Electrium-Mobility/F25-Media-Player-Elec/Import Parts/Models/PJ-327A.step

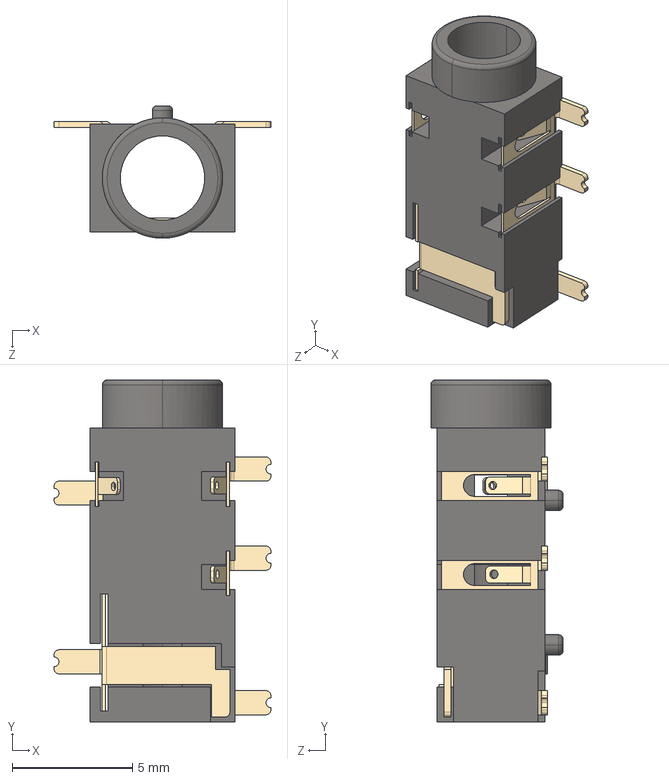
[picture p1: CAD file, 2025-11-14]
Import Parts/Models/PJ-327A.step
9.00 x 14.2 x 5.50 mm
