Electrium-Mobility/F25-Media-Player-Elec/Import Parts/Models/Same_Sky_SJ-3524-SMT-TR.step

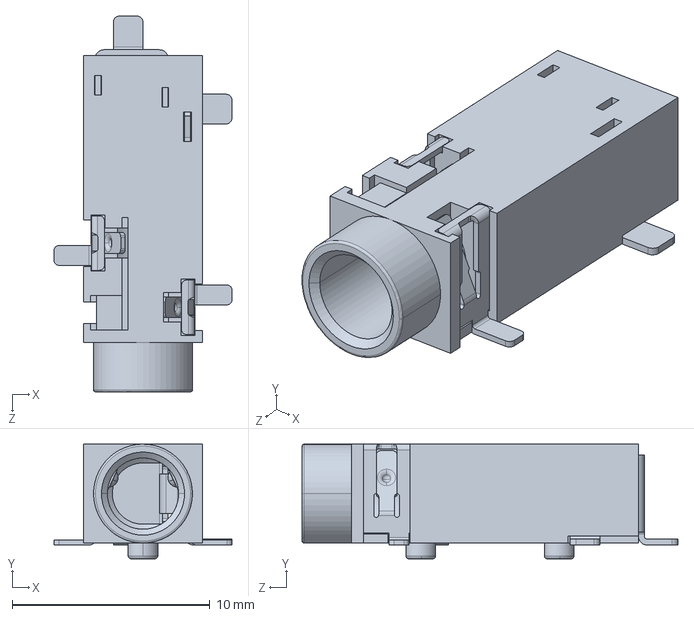
[picture p2: CAD file, 2025-11-05]
Import Parts/Models/Same_Sky_SJ-3524-SMT-TR.step
9.00 x 5.80 x 19.0 mm
