Electrium-Mobility/F25-Media-Player-Elec/Import Parts/Models/664_12402012E212A.stp

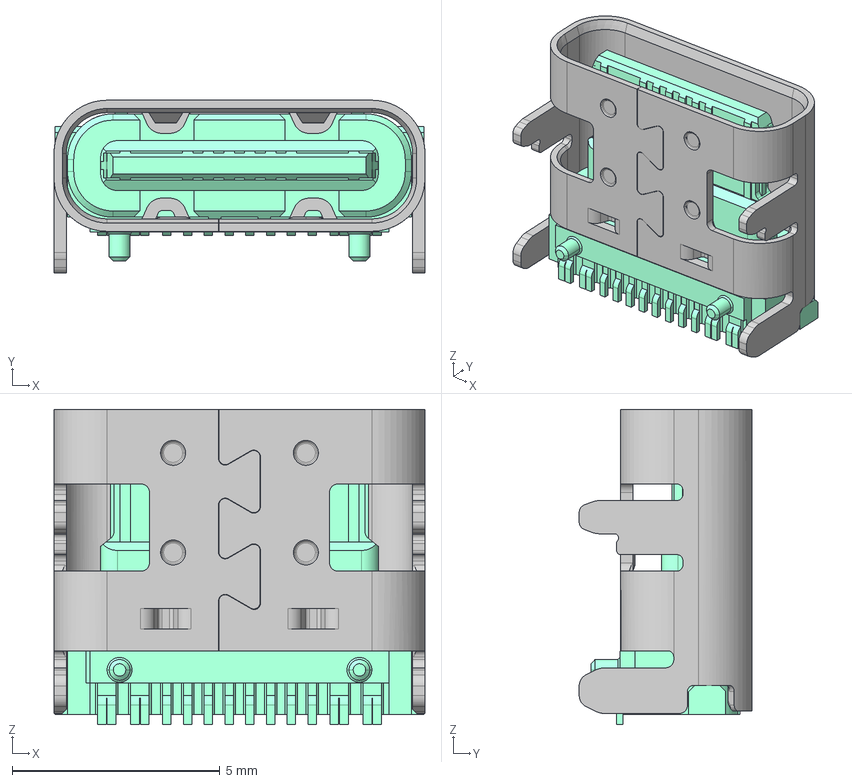
[picture p3: CAD file, 2025-11-05]
Import Parts/Models/664_12402012E212A.stp
8.94 x 4.16 x 7.60 mm
