Electrium-Mobility/F25-Media-Player-Elec/Import Parts/Models/MEM2075-00-140-01-A.stp

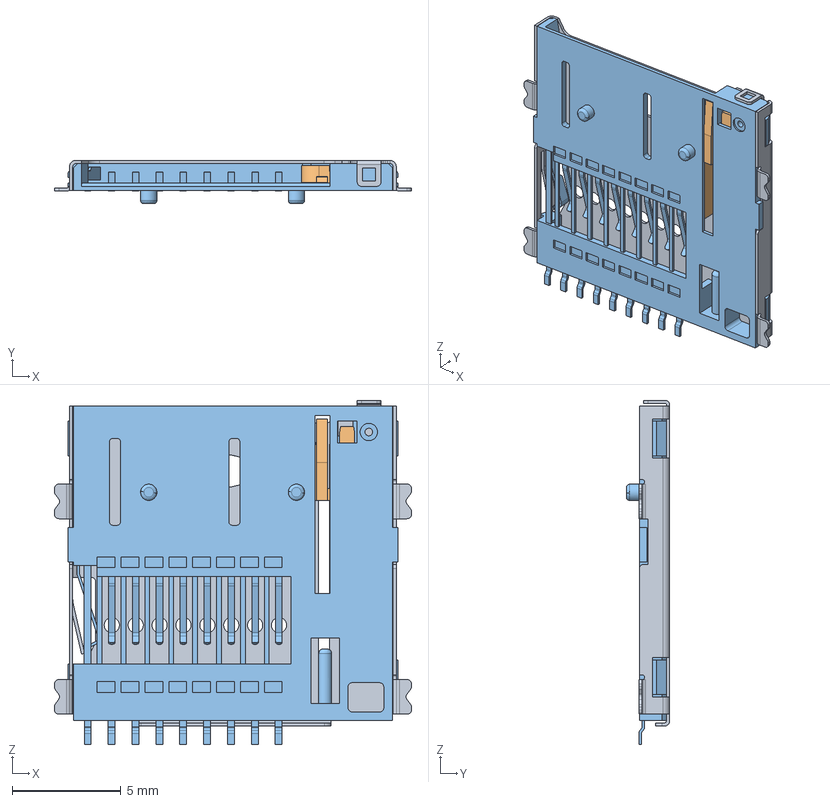
[picture p4: CAD file, 2025-11-05]
Import Parts/Models/MEM2075-00-140-01-A.stp
16.4 x 2.00 x 15.9 mm
MEM2075-00-140-01-A_PART1
MEM2075-00-140-01-A_PART2
MEM2075-00-140-01-A_PART3
