Electrium-Mobility/F25-Media-Player-Elec/Media Player.kicad_pcb

## KiCad design Media Player.kicad_pcb (2025-11-14)

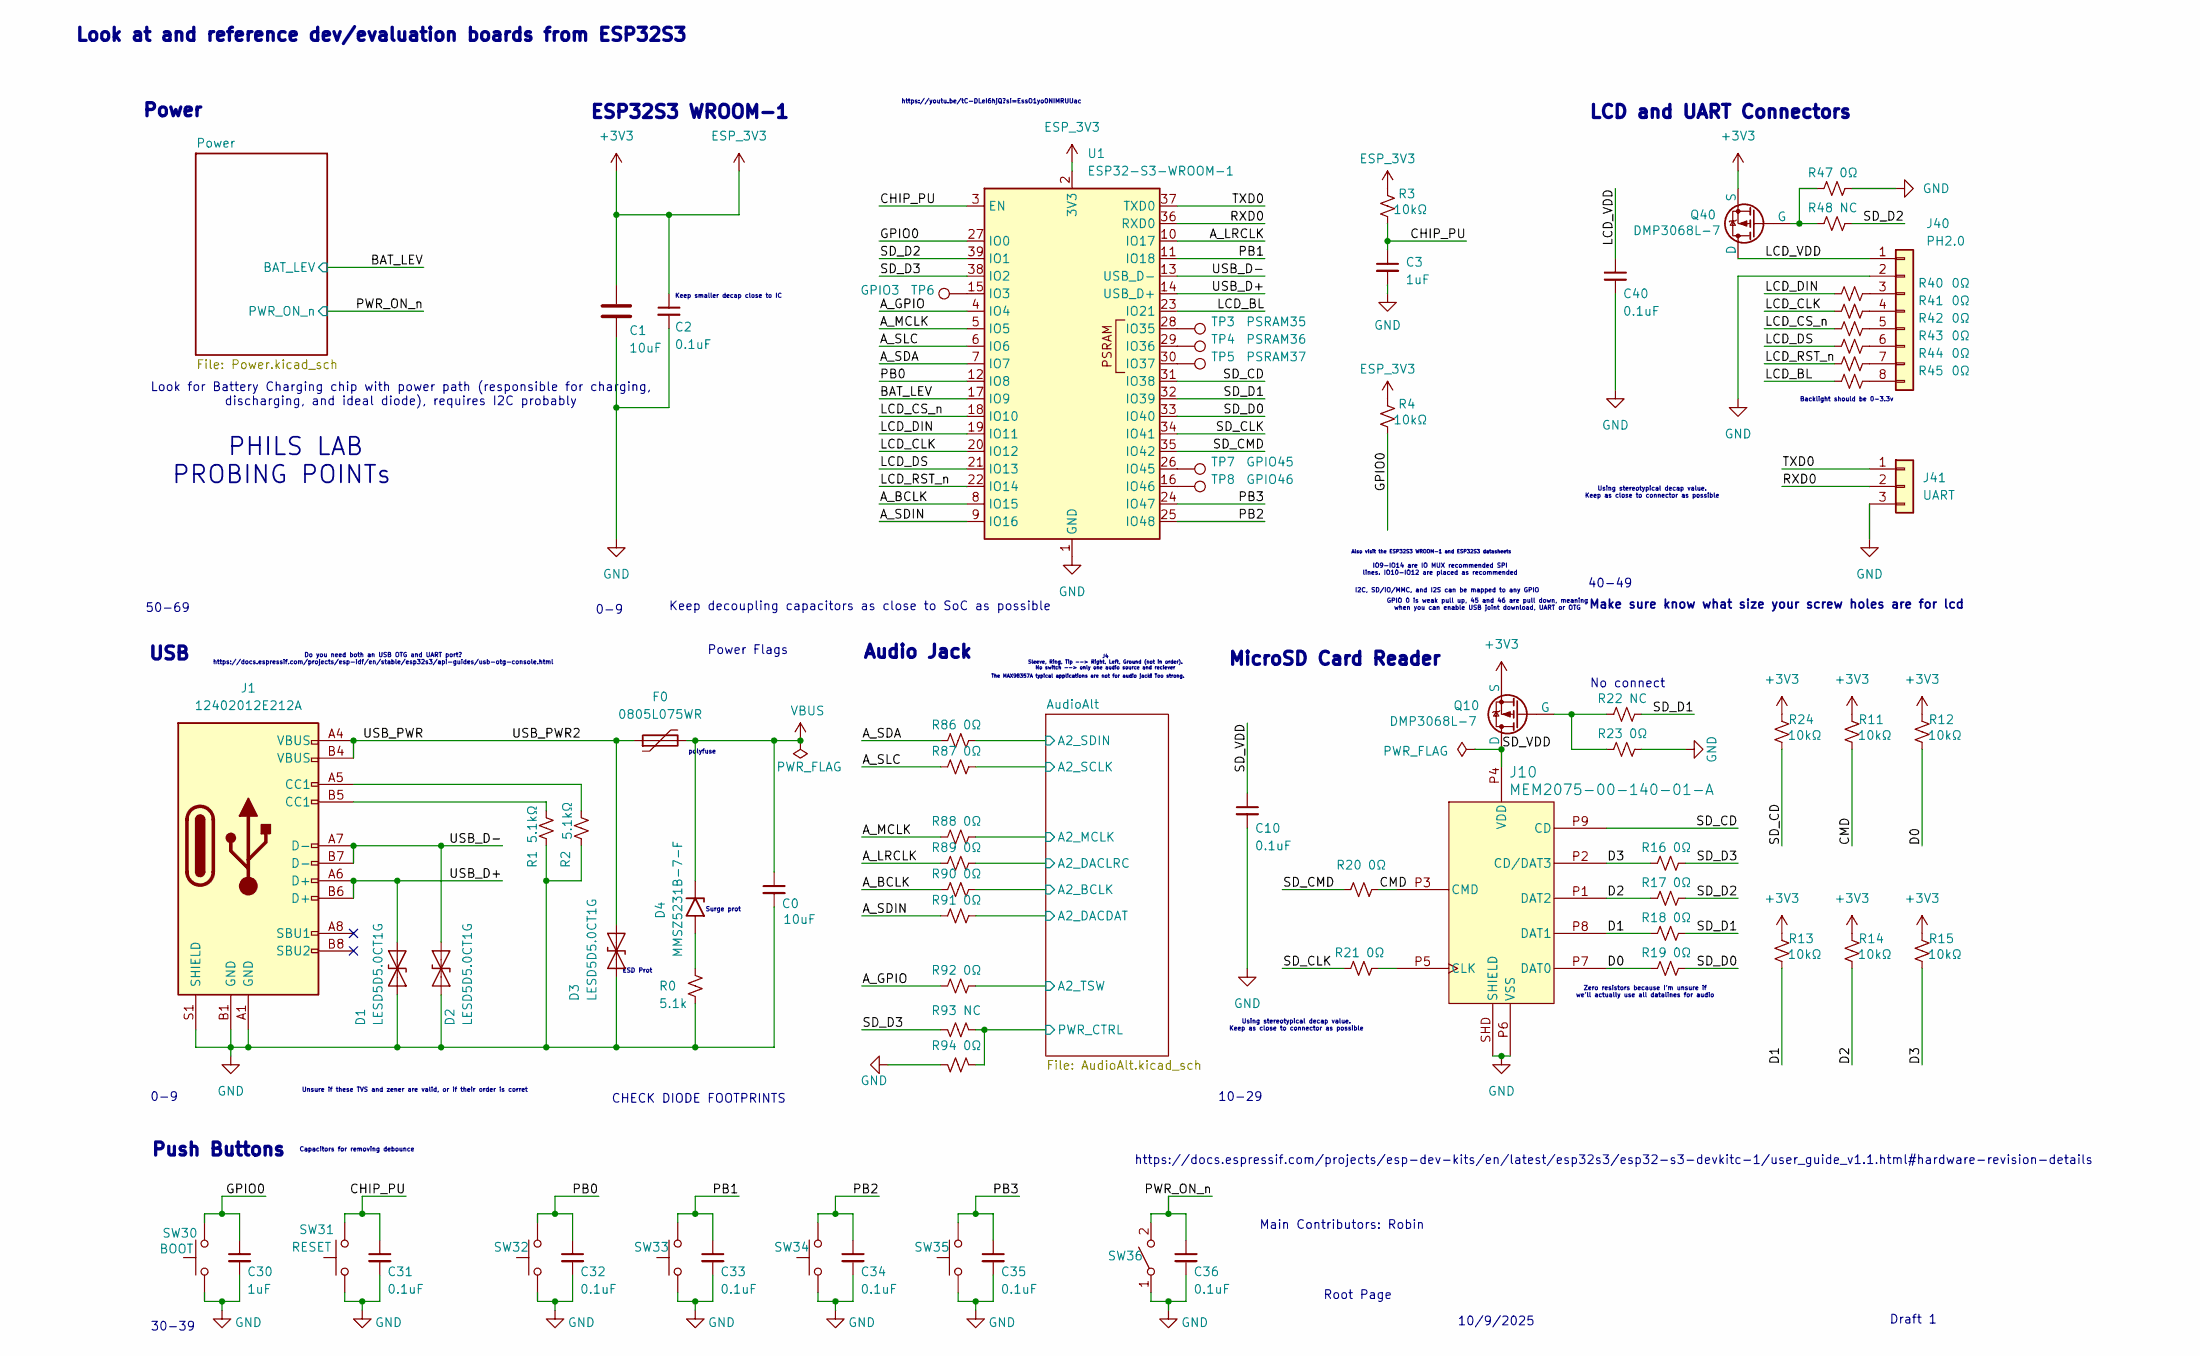
[picture p5: schematic Media Player.kicad_sch]

Parts:
C0: 10uF; C_0805_2012Metric_Pad1.18x1.45mm_HandSolder
C1: 10uF; C_0603_1608Metric_Pad1.08x0.95mm_HandSolder
C2, C10, C31, C32, C33, C34, C35, C36, C40: 0.1uF; C_0603_1608Metric_Pad1.08x0.95mm_HandSolder
C3, C30: 1uF; C_0603_1608Metric_Pad1.08x0.95mm_HandSolder
D1, D2, D3: LESD5D5.0CT1G; D_SOD-523
D4: MMSZ5231B-7-F; D_SOD-323
F0: 0805L075WR; D_0805_2012Metric_Pad1.15x1.40mm_HandSolder
J1: 12402012E212A; USB_C_12402012E212A_AMP
J10: MEM2075-00-140-01-A; MEM2075-00-140-01-A_GCT
J40: PH2.0; JST_EH_B8B-EH-A_1x08_P2.50mm_Vertical
J41: UART; JST_PH_B3B-PH-K_1x03_P2.00mm_Vertical
Q10, Q40: DMP3068L-7; SOT-23-3
R0: 5.1k; R_0603_1608Metric_Pad0.98x0.95mm_HandSolder
R1, R2: 5.1kΩ; R_0603_1608Metric_Pad0.98x0.95mm_HandSolder
R3, R4, R11, R12, R13, R14, R15, R24: 10kΩ; R_0603_1608Metric_Pad0.98x0.95mm_HandSolder
R16, R17, R18, R19, R20, R21, R23, R40, R41, R42, R43, R44, R45, R47, R86, R87, R88, R89, R90, R91, R92, R94: 0Ω; R_0603_1608Metric_Pad0.98x0.95mm_HandSolder
R22, R48, R93: NC; R_0603_1608Metric_Pad0.98x0.95mm_HandSolder
SW30: BOOT; SW_Push_1P1T_NO_CK_KSC6xxG
SW31: RESET; SW_Push_1P1T_NO_CK_KSC6xxG
SW32, SW33, SW34, SW35: SW_Push; SW_Push_1P1T_NO_CK_KSC6xxG
SW36: SW_SPST; SW_DIP_SPSTx01_Slide_6.7x4.1mm_W8.61mm_P2.54mm_LowProfile
TP3: PSRAM35; TestPoint_Pad_1.5x1.5mm
TP4: PSRAM36; TestPoint_Pad_1.5x1.5mm
TP5: PSRAM37; TestPoint_Pad_1.5x1.5mm
TP6: GPIO3; TestPoint_Pad_1.5x1.5mm
TP7: GPIO45; TestPoint_Pad_1.5x1.5mm
TP8: GPIO46; TestPoint_Pad_1.5x1.5mm
U1: ESP32-S3-WROOM-1

Connections:
+3V3: C1.1, C2.1, Q10.3 (S), Q40.3 (S), R3.2, R4.2, R11.2, R12.2, R13.2, R14.2, R15.2, R24.2, U1.2 (3V3); also elsewhere on the board
/A_BCLK: R90.1, U1.8 (IO15)
/A_GPIO: R92.1, U1.4 (IO4)
/A_LRCLK: R89.1, U1.10 (IO17)
/A_MCLK: R88.1, U1.5 (IO5)
/A_SDA: R86.1, U1.7 (IO7)
/A_SDIN: R91.1, U1.9 (IO16)
/A_SLC: R87.1, U1.6 (IO6)
/AudioAlt/A2_BCLK: R90.2; also elsewhere on the board
/AudioAlt/A2_DACDAT: R91.2; also elsewhere on the board
/AudioAlt/A2_DACLRC: R89.2; also elsewhere on the board
/AudioAlt/A2_MCLK: R88.2; also elsewhere on the board
/AudioAlt/A2_SCLK: R87.2; also elsewhere on the board
/AudioAlt/A2_SDIN: R86.2; also elsewhere on the board
/AudioAlt/A2_TSW: R92.2; also elsewhere on the board
/AudioAlt/PWR_CTRL: R93.1, R94.1; also elsewhere on the board
/BAT_LEV: U1.17 (IO9); also elsewhere on the board
/CHIP_PU: C3.1, C31.1, R3.1, SW31.2, U1.3 (EN)
/CMD: J10.P3 (CMD), R11.1, R20.2
/D0: J10.P7 (DAT0), R12.1, R19.1
/D1: J10.P8 (DAT1), R13.1, R18.1
/D2: J10.P1 (DAT2), R14.1, R17.1
/D3: J10.P2 (CD/DAT3), R15.1, R16.1
/GPIO0: C30.1, R4.1, SW30.2, U1.27 (IO0)
/LCD_BL: R45.1, U1.23 (IO21)
/LCD_CLK: R41.1, U1.20 (IO12)
/LCD_CS_n: R42.1, U1.18 (IO10)
/LCD_DIN: R40.1, U1.19 (IO11)
/LCD_DS: R43.1, U1.21 (IO13)
/LCD_RST_n: R44.1, U1.22 (IO14)
/LCD_VDD: C40.1, J40.1, Q40.1 (D)
/PB0: C32.1, SW32.2, U1.12 (IO8)
/PB1: C33.1, SW33.2, U1.11 (IO18)
/PB2: C34.1, SW34.2, U1.25 (IO48)
/PB3: C35.1, SW35.2, U1.24 (IO47)
/PWR_ON_n: C36.1, SW36.2 (B); also elsewhere on the board
/RXD0: J41.2, U1.36 (RXD0)
/SD_CD: J10.P9 (CD), R24.1, U1.31 (IO38)
/SD_CLK: R21.1, U1.34 (IO41)
/SD_CMD: R20.1, U1.35 (IO42)
/SD_D0: R19.2, U1.33 (IO40)
/SD_D1: R18.2, R22.2, U1.32 (IO39)
/SD_D2: R17.2, R48.2, U1.39 (IO1)
/SD_D3: R16.2, R93.2, U1.38 (IO2)
/SD_VDD: C10.1, J10.P4 (VDD), Q10.1 (D)
/TXD0: J41.1, U1.37 (TXD0)
/USB_D+: D1.1 (A1), J1.A6 (D+), J1.B6 (D+), U1.14 (USB_D+)
/USB_D-: D2.1 (A1), J1.A7 (D-), J1.B7 (D-), U1.13 (USB_D-)
/USB_PWR: D3.1 (A1), F0.1, J1.A4 (VBUS), J1.A9 (VBUS), J1.B4 (VBUS), J1.B9 (VBUS)
GND: C0.2, C1.2, C2.2, C3.2, C10.2, C30.2, C31.2, C32.2, C33.2, C34.2, C35.2, C36.2, C40.2, D1.2 (A2), D2.2 (A2), D3.2 (A2), J1.A1 (GND), J1.A12 (GND), J1.B1 (GND), J1.B12 (GND), J1.S1 (SHIELD), J10.P6 (VSS), J10.SHD (SHIELD), J40.2, J41.3, R0.2, R1.2, R2.2, R23.2, R47.2, R94.2, SW30.1, SW31.1, SW32.1, SW33.1, SW34.1, SW35.1, SW36.1 (A), U1.1 (GND), U1.40 (GND), U1.41 (GND); also elsewhere on the board
unnamed: D4.2 (A2), R0.1
unnamed: J1.A5 (CC1), R2.1
unnamed: J1.B5 (CC1), R1.1
unnamed: J10.P5 (CLK), R21.2
unnamed: J40.3, R40.2
unnamed: J40.4, R41.2
unnamed: J40.5, R42.2
unnamed: J40.6, R43.2
unnamed: J40.7, R44.2
unnamed: J40.8, R45.2
unnamed: Q10.2 (G), R22.1, R23.1
unnamed: Q40.2 (G), R47.1, R48.1
unnamed: TP6.1, U1.15 (IO3)
unnamed: TP3.1, U1.28 (IO35)
unnamed: TP4.1, U1.29 (IO36)
unnamed: TP5.1, U1.30 (IO37)
unnamed: TP7.1, U1.26 (IO45)
unnamed: TP8.1, U1.16 (IO46)
VBUS: C0.1, D4.1 (A1), F0.2; also elsewhere on the board

Notes on the sheet:
LCD and UART Connectors
Look for Battery Charging chip with power path (responsible for charging, discharging, and ideal diode), requires I2C probably
Keep decoupling capacitors as close to SoC as possible
50-69
ESP32S3 WROOM-1
Capacitors for removing debounce
Look at and reference dev/evaluation boards from ESP32S3
IO9-IO14 are IO MUX recommended SPI lines. IO10-IO12 are placed as recommended
Make sure know what size your screw holes are for lcd
GPIO 0 is weak pull up, 45 and 46 are pull down, meaning when you can enable USB joint download, UART or OTG
Push Buttons
Using stereotypical decap value. Keep as close to connector as possible
MicroSD Card Reader
Backlight should be 0-3.3v
0-9
I2C, SD/IO/MMC, and I2S can be mapped to any GPIO
Surge prot
10/9/2025
Root Page
Zero resistors because I'm unsure if we'll actually use all datalines for audio
10-29
Unsure if these TVS and zener are valid, or if their order is corret
CHECK DIODE FOOTPRINTS
Power
polyfuse
40-49
Audio Jack
30-39
Do you need both an USB OTG and UART port? https://docs.espressif.com/projects/esp-idf/en/stable/esp32s3/api-guides/usb-otg-console.html
PROBING POINTs
The MAX98357A typical applications are not for audio jack! Too strong.
Also visit the ESP32S3 WROOM-1 and ESP32S3 datasheets
Keep smaller decap close to IC
Main Contributors: Robin
No connect
PHILS LAB
Draft 1
ESD Prot
USB
https://docs.espressif.com/projects/esp-dev-kits/en/latest/esp32s3/esp32-s3-devkitc-1/user_guide_v1.1.html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
J4 Sleeve, Ring, Tip --> Right, Left, Ground (not in order). No switch --> only one audio source and reciever
Power Flags
https://youtu.be/tC-DLeI6hjQ?si=EssO1yo0NIMRUUac

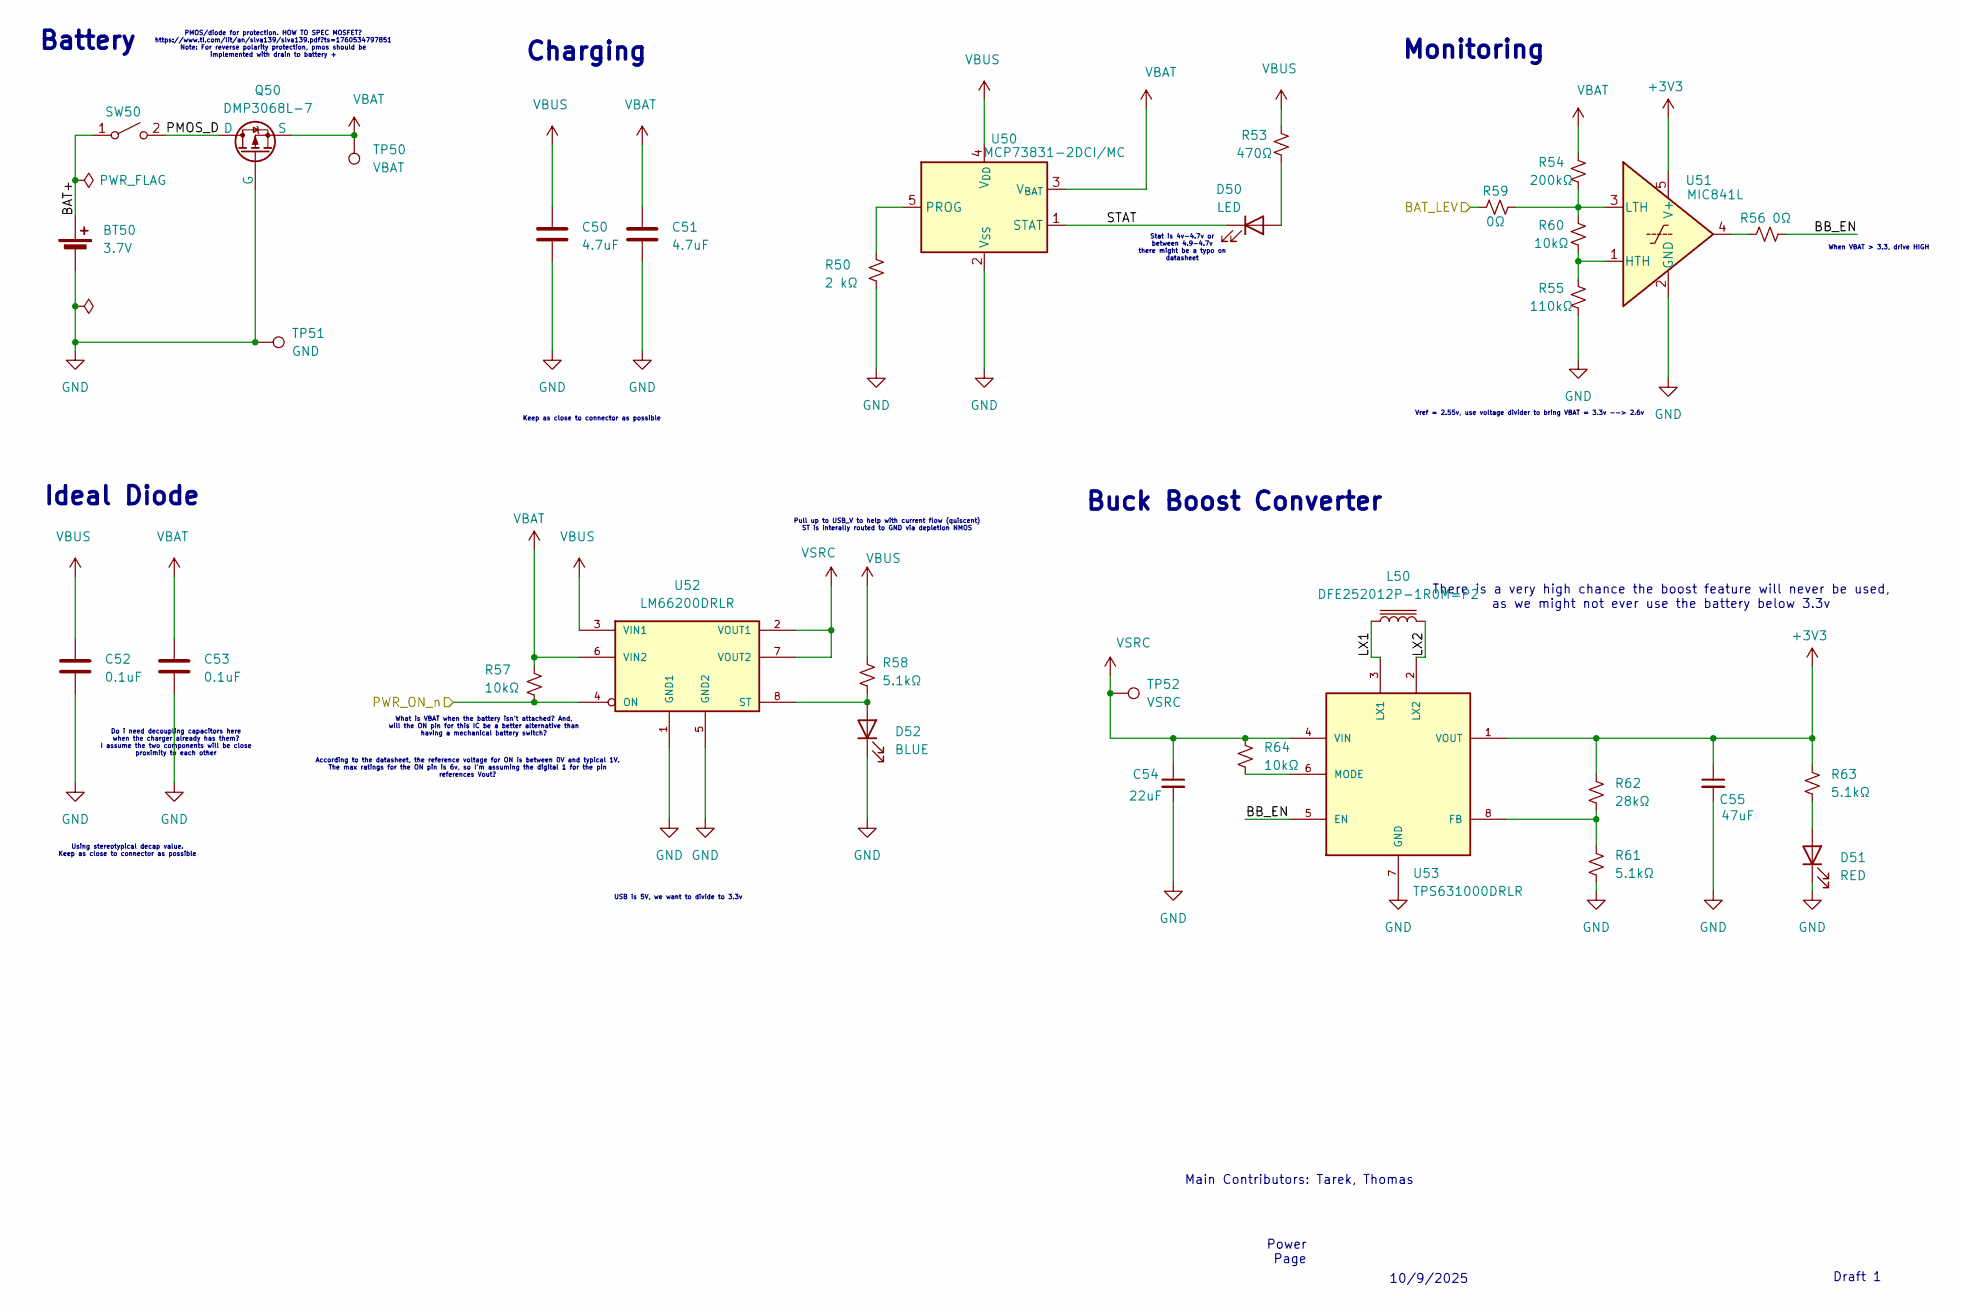
[picture p6: schematic Power.kicad_sch]

Parts:
BT50: 3.7V; JST_PH_B2B-PH-K_1x02_P2.00mm_Vertical
C50, C51: 4.7uF; C_0603_1608Metric_Pad1.08x0.95mm_HandSolder
C52, C53: 0.1uF; C_0603_1608Metric_Pad1.08x0.95mm_HandSolder
C54: 22uF; C_0805_2012Metric
C55: 47uF; C_0805_2012Metric
D50: LED; LED_0603_1608Metric
D51: RED; LED_0603_1608Metric
D52: BLUE; LED_0603_1608Metric
L50: DFE252012P-1R0M=P2; L_1008_2520Metric
Q50: DMP3068L-7; SOT-23-3
R50: 2 kΩ; R_0603_1608Metric_Pad0.98x0.95mm_HandSolder
R53: 470Ω; R_0603_1608Metric_Pad0.98x0.95mm_HandSolder
R54: 200kΩ; R_0603_1608Metric_Pad0.98x0.95mm_HandSolder
R55: 110kΩ; R_0603_1608Metric_Pad0.98x0.95mm_HandSolder
R56, R59: 0Ω; R_0603_1608Metric_Pad0.98x0.95mm_HandSolder
R57, R60, R64: 10kΩ; R_0603_1608Metric_Pad0.98x0.95mm_HandSolder
R58, R61, R63: 5.1kΩ; R_0603_1608Metric_Pad0.98x0.95mm_HandSolder
R62: 28kΩ; R_0603_1608Metric_Pad0.98x0.95mm_HandSolder
SW50: SW_SPST; SW_DIP_SPSTx01_Slide_6.7x4.1mm_W8.61mm_P2.54mm_LowProfile
TP50: VBAT; TestPoint_Pad_1.5x1.5mm
TP51: GND; TestPoint_THTPad_1.5x1.5mm_Drill0.7mm
TP52: VSRC; TestPoint_Pad_1.5x1.5mm
U50: MCP73831-2DCI/MC; SOT-23-5
U51: MIC841L; SOT-353_SC-70-5
U52: LM66200DRLR; SOT-583-8
U53: TPS631000DRLR; SOT-583-8; PARTREV B

Connections:
+3V3: C55.1, R62.1, R63.1, U51.5 (V+), U53.1 (VOUT); also elsewhere on the board
/BAT_LEV: R59.2; also elsewhere on the board
/PWR_ON_n: R57.2, U52.4 (ON); also elsewhere on the board
/Power/BAT+: BT50.1 (+), SW50.1 (A)
/Power/BB_EN: R56.2, U53.5 (EN)
/Power/LX1: L50.1, U53.3 (LX1)
/Power/LX2: L50.2, U53.2 (LX2)
/Power/PMOS_D: Q50.1 (D), SW50.2 (B)
/Power/STAT: D50.1 (K), U50.1 (STAT)
GND: BT50.2 (-), C50.1, C51.1, C52.1, C53.1, C54.2, C55.2, D51.1 (K), D52.1 (K), Q50.2 (G), R50.2, R55.1, R61.2, TP51.1, U50.2 (V_{SS}), U51.2 (GND), U52.1 (GND1), U52.5 (GND2), U53.7 (GND); also elsewhere on the board
unnamed: D50.2 (A), R53.1
unnamed: D51.2 (A), R63.2
unnamed: D52.2 (A), R58.2, U52.8 (ST)
unnamed: R56.1, U51.4
unnamed: R50.1, U50.5 (PROG)
unnamed: R55.2, R60.1, U51.1 (HTH)
unnamed: R54.1, R59.1, R60.2, U51.3 (LTH)
unnamed: R61.1, R62.2, U53.8 (FB)
unnamed: R64.2, U53.6 (MODE)
VBAT: C51.2, C53.2, Q50.3 (S), R54.2, R57.1, TP50.1, U50.3 (V_{BAT}), U52.6 (VIN2)
VBUS: C50.2, C52.2, R53.2, R58.1, U50.4 (V_{DD}), U52.3 (VIN1); also elsewhere on the board
VSRC: C54.1, R64.1, TP52.1, U52.2 (VOUT1), U52.7 (VOUT2), U53.4 (VIN)

Notes on the sheet:
Pull up to USB_V to help with current flow (quiscent) ST is interally routed to GND via depletion NMOS
Power Page
Vref = 2.55v, use voltage divider to bring VBAT = 3.3v --> 2.6v
Do i need decoupling capacitors here when the charger already has them? I assume the two components will be close proximity to each other
According to the datasheet, the reference voltage for ON is between 0V and typical 1V. The max ratings for the ON pin is 6v, so I'm assuming the digital 1 for the pin references Vout?
What is VBAT when the battery isn't attached? And, will the ON pin for this IC be a better alternative than having a mechanical battery switch?
Keep as close to connector as possible
Charging
Main Contributors: Tarek, Thomas
Battery
10/9/2025
There is a very high chance the boost feature will never be used, as we might not ever use the battery below 3.3v
When VBAT > 3.3, drive HIGH
Ideal Diode
Using stereotypical decap value. Keep as close to connector as possible
Buck Boost Converter
Draft 1
USB is 5V, we want to divide to 3.3v
Monitoring
PMOS/diode for protection. HOW TO SPEC MOSFET? https://www.ti.com/lit/an/slva139/slva139.pdf?ts=1760534797851 Note: For reverse polarity protection, pmos should be implemented with drain to battery +
Stat is 4v-4.7v or between 4.9-4.7v there might be a typo on datasheet

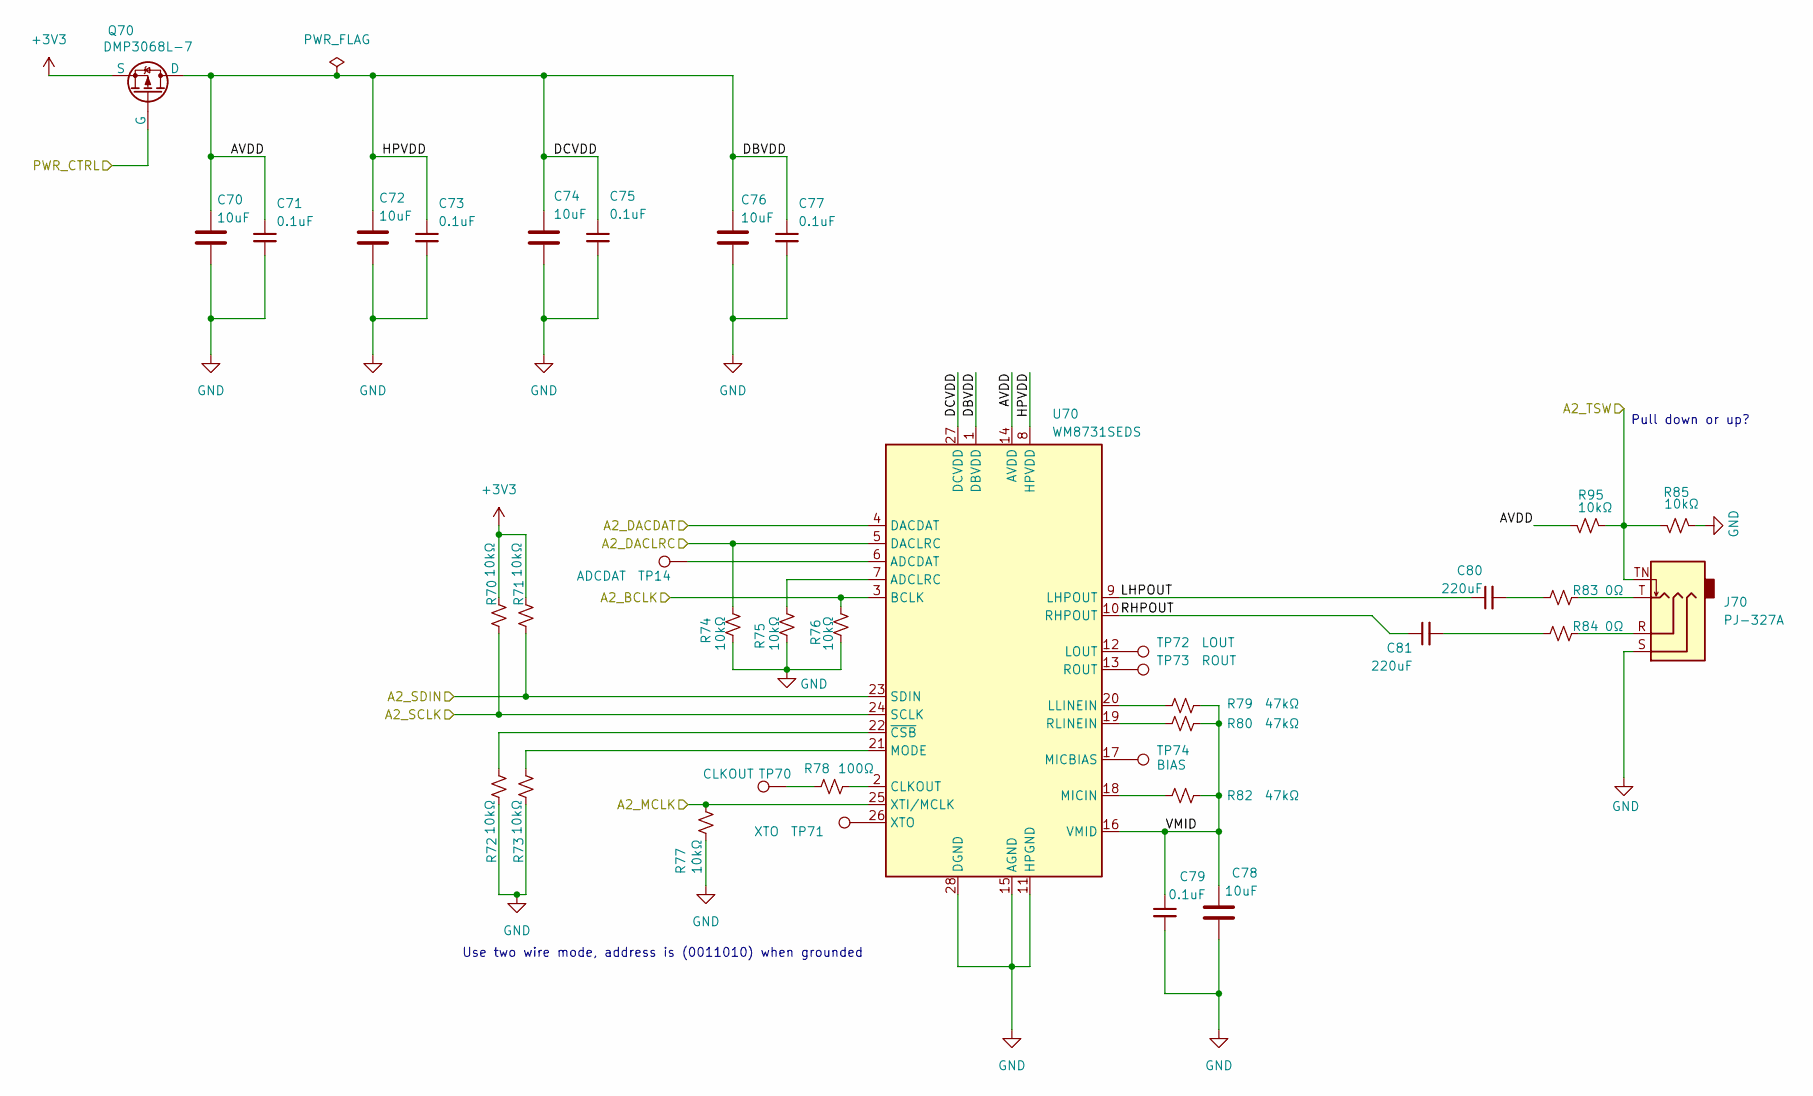
[picture p7: schematic AudioAlt.kicad_sch]

Parts:
C70, C72, C74, C76, C78: 10uF; C_0603_1608Metric_Pad1.08x0.95mm_HandSolder
C71, C73, C75, C77, C79: 0.1uF; C_0603_1608Metric_Pad1.08x0.95mm_HandSolder
C80, C81: 220uF; C_0603_1608Metric_Pad1.08x0.95mm_HandSolder
J70: PJ-327A; Korean Hroparts Elec PJ-327C-4A
Q70: DMP3068L-7; SOT-23-3
R70, R71, R72, R73, R74, R75, R76, R77, R85, R95: 10kΩ; R_0603_1608Metric_Pad0.98x0.95mm_HandSolder
R78: 100Ω; R_0603_1608Metric_Pad0.98x0.95mm_HandSolder
R79, R80, R82: 47kΩ; R_0603_1608Metric_Pad0.98x0.95mm_HandSolder
R83, R84: 0Ω; R_0603_1608Metric_Pad0.98x0.95mm_HandSolder
TP14: ADCDAT; TestPoint_Pad_1.5x1.5mm
TP70: CLKOUT; TestPoint_Pad_1.5x1.5mm
TP71: XTO; TestPoint_Pad_1.5x1.5mm
TP72: LOUT; TestPoint_Pad_1.5x1.5mm
TP73: ROUT; TestPoint_Pad_1.5x1.5mm
TP74: BIAS; TestPoint_Pad_1.5x1.5mm
U70: WM8731SEDS; SSOP-28_5.3x10.2mm_P0.65mm

Connections:
+3V3: Q70.3 (S), R70.1, R71.1; also elsewhere on the board
/AudioAlt/A2_BCLK: R76.1, U70.3 (BCLK); also elsewhere on the board
/AudioAlt/A2_DACDAT: U70.4 (DACDAT); also elsewhere on the board
/AudioAlt/A2_DACLRC: R74.1, U70.5 (DACLRC); also elsewhere on the board
/AudioAlt/A2_MCLK: R77.1, U70.25 (XTI/MCLK); also elsewhere on the board
/AudioAlt/A2_SCLK: R70.2, U70.24 (SCLK); also elsewhere on the board
/AudioAlt/A2_SDIN: R71.2, U70.23 (SDIN); also elsewhere on the board
/AudioAlt/A2_TSW: J70.TN, R85.1, R95.2; also elsewhere on the board
/AudioAlt/AVDD: C70.1, C71.1, C72.1, C73.1, C74.1, C75.1, C76.1, C77.1, Q70.1 (D), R95.1, U70.1 (DBVDD), U70.8 (HPVDD), U70.14 (AVDD), U70.27 (DCVDD)
/AudioAlt/LHPOUT: C80.1, U70.9 (LHPOUT)
/AudioAlt/PWR_CTRL: Q70.2 (G); also elsewhere on the board
/AudioAlt/RHPOUT: C81.1, U70.10 (RHPOUT)
/AudioAlt/VMID: C78.1, C79.1, R79.1, R80.1, R82.1, U70.16 (VMID)
GND: C70.2, C71.2, C72.2, C73.2, C74.2, C75.2, C76.2, C77.2, C78.2, C79.2, J70.S, R72.2, R73.2, R74.2, R75.2, R76.2, R77.2, R85.2, U70.11 (HPGND), U70.15 (AGND), U70.28 (DGND); also elsewhere on the board
unnamed: C80.2, R83.1
unnamed: C81.2, R84.1
unnamed: J70.R, R84.2
unnamed: J70.T, R83.2
unnamed: R78.2, TP70.1
unnamed: TP14.1, U70.6 (ADCDAT)
unnamed: R75.1, U70.7 (ADCLRC)
unnamed: R78.1, U70.2 (CLKOUT)
unnamed: R79.2, U70.20 (LLINEIN)
unnamed: TP72.1, U70.12 (LOUT)
unnamed: TP74.1, U70.17 (MICBIAS)
unnamed: R82.2, U70.18 (MICIN)
unnamed: R73.1, U70.21 (MODE)
unnamed: R80.2, U70.19 (RLINEIN)
unnamed: TP73.1, U70.13 (ROUT)
unnamed: TP71.1, U70.26 (XTO)
unnamed: R72.1, U70.22 (~CSB)

Notes on the sheet:
Use two wire mode, address is (0011010) when grounded
Pull down or up?

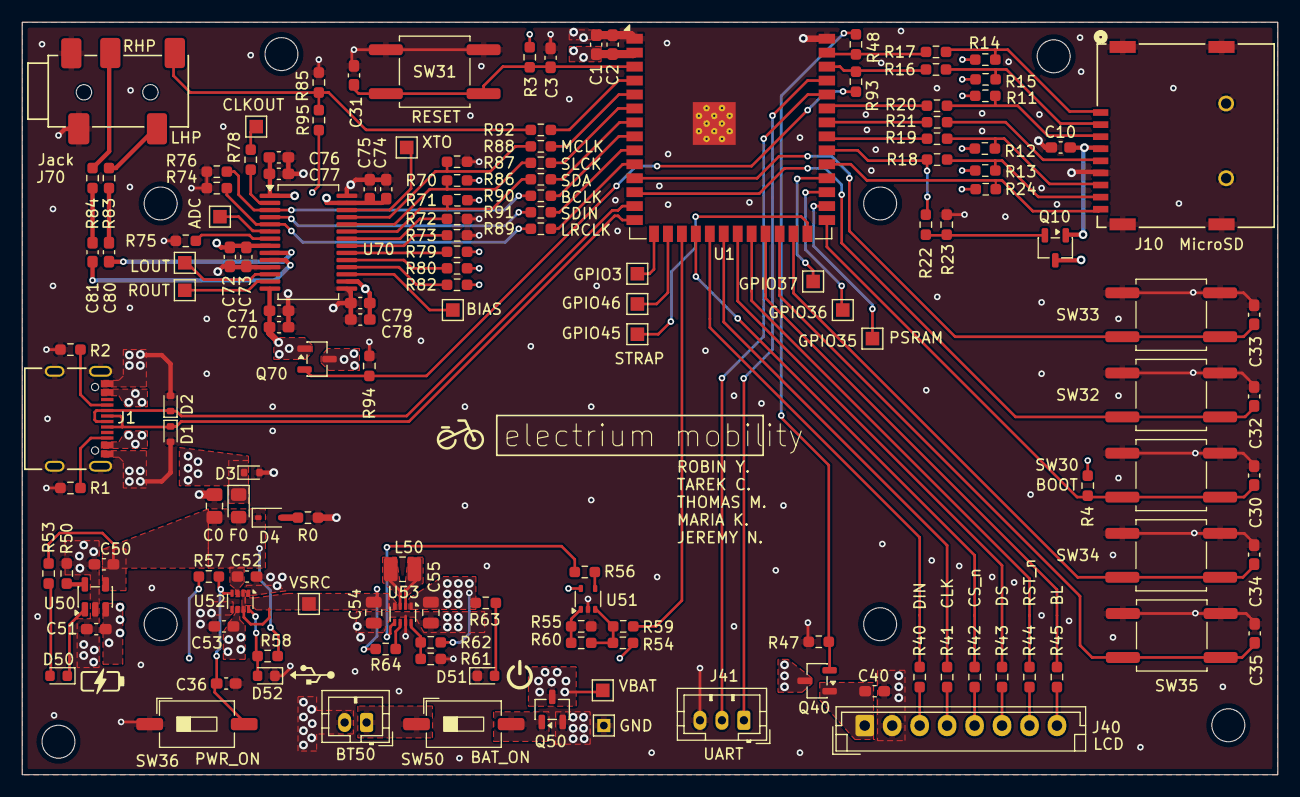
[picture p8: board Media Player.kicad_pcb from above]

Board: 4 copper layers, 114.3 x 68.5 mm, 144 parts (0 on the bottom side), 107 nets.
