Electrium-Mobility/F25-Media-Player-Elec/(commit log)

2025-10-02 Update Media Player.kicad_sch
    [Media Player.kicad_sch]
2025-10-03 Added Power sub page.
    [Media Player.kicad_sch, Power.kicad_sch]
2025-10-03 Placed Major Components, No Power
    Placed ESP32S3, Connector to LCD, SD card reader, USB. Audio Jack components still tbd. Power is a hierarchical page/symbol, no pins right now.
    Note to self: KiCAD will crash if you try to edit symbols by double clicking on them inside a schematic. Use symbol editor instead.
    [Media Player.kicad_sch]
2025-10-07 Most connections formed except component values and audio amp
    [Media Player.kicad_sch, Power.kicad_sch]
2025-10-08 Changed Audio Amplifier to MAX9850
    MAX9850 is so complicated - you use I2C to set the internal registers to modify and initialize the IC before you use I2S to send audio data to DAC. You can also choose to send analog data with AC coupling capacitors. Output can go to speaker and headphone jack. Very versatile, extremely annoying reading a 36 page data sheet for 2 hours. No power yet.
    [Audio.kicad_sch, Media Player.kicad_sch]
2025-10-09 Draft 1 - Main components and wiring complete
    Connections may be innacurate or violate electrical specs, or perhaps aren't set up "properly".
    [Audio.kicad_sch, Media Player.kicad_sch, Power.kicad_sch]
2025-10-09 Added missing datasheets.
    [Audio.kicad_sch, Media Player.kicad_sch, Power.kicad_sch]
2025-10-09 Added PMOS to battery + power flags
    Still missing values for a lot of components
    [Audio.kicad_sch, Media Player.kicad_sch, Power.kicad_sch]
2025-10-12 Added most of the footprints needed
    [Audio.kicad_sch, Media Player.kicad_sch, Power.kicad_sch]
2025-10-13 Finished off the last footprints
    [Audio.kicad_sch, Media Player.kicad_sch, Power.kicad_sch]
2025-10-15 Draft 2: Protection circuitry and fixed I/O signals
    Still missing PMOS spec for reverse polarity battery protection. Added TVS to USB, voltage divided certain output signals from ICs into ESP GPIO. Checked some component values.
    [Audio.kicad_sch, Media Player.kicad_sch, Power.kicad_sch]
2025-10-15 Removed comment block
    [Media Player.kicad_sch]
2025-10-17 Draft 2 Revision 2
    Footprints still not all assigned.
    Added: Test points, zero resistors, battery voltage monitor IC, PTC and zener surge protection on VBUS, UART connector
    Changed: rerouted some signals, removed zener and resistor for reverse pol bat protection
    [Audio.kicad_sch, Media Player.kicad_sch, Power.kicad_sch]
2025-10-20 Remaining Footprint Added
    Beware of footprints that come from online but do not match the kicad libraries - the pins might be mapped wrong!
    [Audio.kicad_sch, Media Player.kicad_sch, Power.kicad_sch]
2025-10-20 Components Placed on Layout
    Added Power Management PMOS, Assigned missing footprints
    [Audio.kicad_sch, Media Player.kicad_pcb, Media Player.kicad_sch, Power.kicad_sch]
2025-10-20 Filtered Ratsnest
    Moved all related components into their respective groups
    [Media Player.kicad_pcb]
2025-10-24 Ratsnest organized
    Certain pins on esp32 module changed to benefit layout. Named all decaps to dC. Current layout areas might be not optimal, i.e. complicated to wire
    [Audio.kicad_sch, Media Player.kicad_pcb, Media Player.kicad_sch, Power.kicad_sch]
2025-10-27 Component Re-order
    [Media Player.kicad_pcb, Media Player.kicad_sch]
2025-10-27 Added alternative audio IC
    Added a SOP package audio IC (for easier board bring up) in hopes to replace MAX9850. Pins not fully mapped yet.
    [Audio.kicad_sch, AudioAlt.kicad_sch, Media Player.kicad_sch, untitled.kicad_sch]
2025-10-29 Board stuffing, new audio on board
    Added new Audio IC to PCB.
    Started moving everything into a estimated board size, AKA restricted area. Things seem REALL TIGHT. There's not enough space, I think I'll have to change resistor footprints
    [AudioAlt.kicad_sch, Media Player.kicad_pcb, Media Player.kicad_sch]
2025-10-31 Draft 1
    I'm not very fond of some of my traces. Especially the power component. Not even sure if all components are routed properly. Still missing GND and PWR plane, so most component power not routed. Missing LCD screw holes. Power and signal traces are using same width/thickness, and also have not checked with what JLC allows during fabrication. I should try again, working from general (blocking) to specifics (details), much like how I started with schematics. Many conventions I have not learned.
    [Media Player.kicad_pcb, Media Player.kicad_sch]
2025-10-31 Temporary Commit
    [Media Player.kicad_pcb]
2025-11-01 Small Change to USB routing
    Removed 0 resistors and change components to match reference schematic
    [Media Player.kicad_pcb, Media Player.kicad_sch, Power.kicad_sch]
2025-11-01 Compacting part 1
    [AudioAlt.kicad_sch, Media Player.kicad_pcb, Media Player.kicad_sch, Power.kicad_sch]
2025-11-03 Compacting Part 2, Pre-Draft 2
    Compacted more parts. Organized power routing and added envisioned power plane sections. Added screw holes for board and LCD. Shrunk max board size down.
    Still need to replace the diode for surge prot as the copper pads are way too small for direction large amounts of current.
    [Media Player.kicad_pcb]
2025-11-05 JLC Design restraints
    Updated design rules with JLC PCB. Combined numbers from Phils Lab and GPT for beginner friendly values (first board)
    [664_12402012E212A.stp, MEM2075-00-140-01-A.stp, Media Player.kicad_pcb, Media Player.kicad_sch, Same_Sky_SJ-3524-SMT-TR.step]
2025-11-05 Bucked
    The Boost Buck Converter layout is from the datasheet. I'm not really sure how many via's I'll need for power since the IC is so small yet its the only source of power feeding all the other peripherals.
    [Media Player.kicad_pcb, Power.kicad_sch]
2025-11-06 Ideal Diode
    Layout based on ds
    [Media Player.kicad_pcb]
2025-11-07 Layout Draft 2, or almost
    Charger layout based off of reference. Used more copper regions rather than traces. Other traces like buttons and test pads routed. Tried my best to make it all look good and parallel.
    Added more silkscreen and logo.
    STILL NEED TO DO POWER PLANE.
    [Media Player.kicad_pcb, Media Player.kicad_sch, Power.kicad_sch]
2025-11-07 Layout 2! Pre-DRC
    32 DRC errors. 116 Warnings.
    Inserted power planes. Now is time for optimization and fixing.
    [Media Player.kicad_pcb]
2025-11-08 Most DRC errors removed EXCEPT USB
    USB receptacle pins are too close to each other and the design rules I set are upset
    (31 errors, 1.9mm instead of the minimum 2.0mm)
    [Media Player.kicad_pcb]
2025-11-09 Copper Ground Pour, Traces Moved to Upper Layer
    Replaced gnd trace around D+ D- and SDIO CLK with full board GND pour. DRC issues with gnd pour right now. Also moved a lot of un-necessary back layer signal traces to top layer. DRC still somewhat unfixed.
    [Media Player.kicad_pcb]
2025-11-11 Minor Changes
    Power traces enlarged, certain pad and hole clearances on USB modified, still within design rules, fixed silk screen clearance, copper pours now with thermal relief for pads connected to large planes. Most DRC's resolved. Design rule constraints tuned very slightly.
    [Media Player.kicad_pcb]
2025-11-13 Ground Stitching, PMOS 0-Res Moved,
    DRC should be near cleared. Might want to reconsider mapping some pin functions? SD card detect line, also battery checker (making use of comparator). Also, double check if audio IC microphone pins (and ADC) are supposed to be pulled to VMID
    [AudioAlt.kicad_sch, Media Player.kicad_pcb, Media Player.kicad_sch, Power.kicad_sch]
2025-11-14 UNFINISHED: Rerouted Traces, new LEDs, replaced components
    Removed charging status and power source signals from MCU and gave them their own LEDs. Added analog battery voltage and card detect as replacement. Also found out not all components are in stock... troubling to find replacements :( should have done this during schematic
    [AudioAlt.kicad_sch, Media Player.kicad_pcb, Media Player.kicad_sch, Power.kicad_sch]
2025-11-14 New Audio Jack
    Replaced audio jack with actually available component from xunpu, changed MIC845 to MIC841. Still need to double check the audio codec
    [Media Player.kicad_pcb, PJ-327A.step]
2025-11-14 No changes made.
    [AudioAlt.kicad_sch, Media Player.kicad_pcb]
2025-11-14 ORDERED: Updated Footprints, Silk Screen, Mounting Holes
    Minor changes. This is the version sent to JLC
    [AudioAlt.kicad_sch, Media Player.kicad_pcb, Media Player.kicad_sch, MediaPlayer11142025_bom.csv, MediaPlayer11142025_designators.csv, MediaPlayer11142025_positions.csv, Power.kicad_sch]
