Electrium-Mobility/F25-Media-Player-Elec/(notices)

Notices in the files:
Import Parts/Models/MEM2075-00-140-01-A.stp:
author */ ('License CC BY-ND 4.0'),
